simpliaelectronics/compact-hw/M.2/imxrt1052/README.md

# COMPACT 1052 Module documentation pack

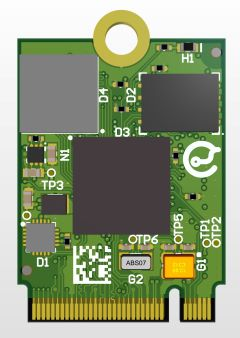
[picture p1: M.2/imxrt1052/images/compact_imxrt1052.jpg]
Compact imxrt1052


This pack includes:

* [Datasheet](/M.2/imxrt1052/DATASHEET.md)
* [Dimensional drawing](/M.2/imxrt1052/MOD_IMXRT_COMPACT_DIM.pdf)
* [3D STEP file](/M.2/imxrt1052/MOD_IMXRT_COMPACT.step)
* [Component footprint](/M.2/imxrt1052/Placement_Layout.pdf)

All documents correspond to HW revision 1.
