simpliaelectronics/compact-hw/M.2/imxrt1052/MOD_IMXRT_COMPACT.step

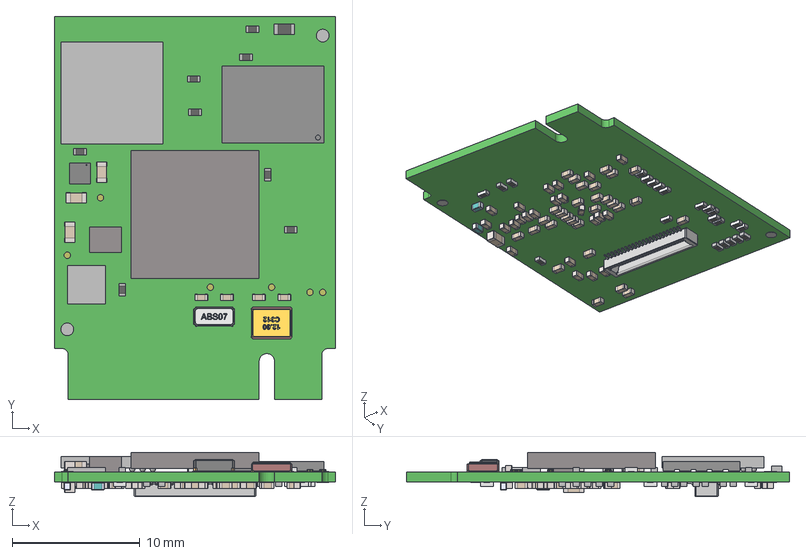
[picture p6: CAD file, 2021-03-10]
M.2/imxrt1052/MOD_IMXRT_COMPACT.step
22.0 x 30.0 x 3.46 mm
SMD_CAPACITOR_0603 x 4
Extruded x 10
SMD_RESISTOR_0402 x 30
TMLF-6_MT_MCH-L
SMD_CAPACITOR_0402 x 56
SMD_INDUCTOR_0402 x 2
DF40C-40DP
W25Q128JVEIQ
SMD_RESISTOR_0603
User_Library-ABS07_ABS07_Body_2
User_Library-ABS07_ABS07_Body2_2
User_Library-ABS07_ABS07_Beschriftung_2
User_Library-ABS07_ABS07_Pads_2
Cuartz_Crystal_3.2x2.5_SMT_4PAD
