simpliaelectronics/compact-hw/M.2/imxrt1052/MOD_IMXRT_COMPACT_DIM.pdf

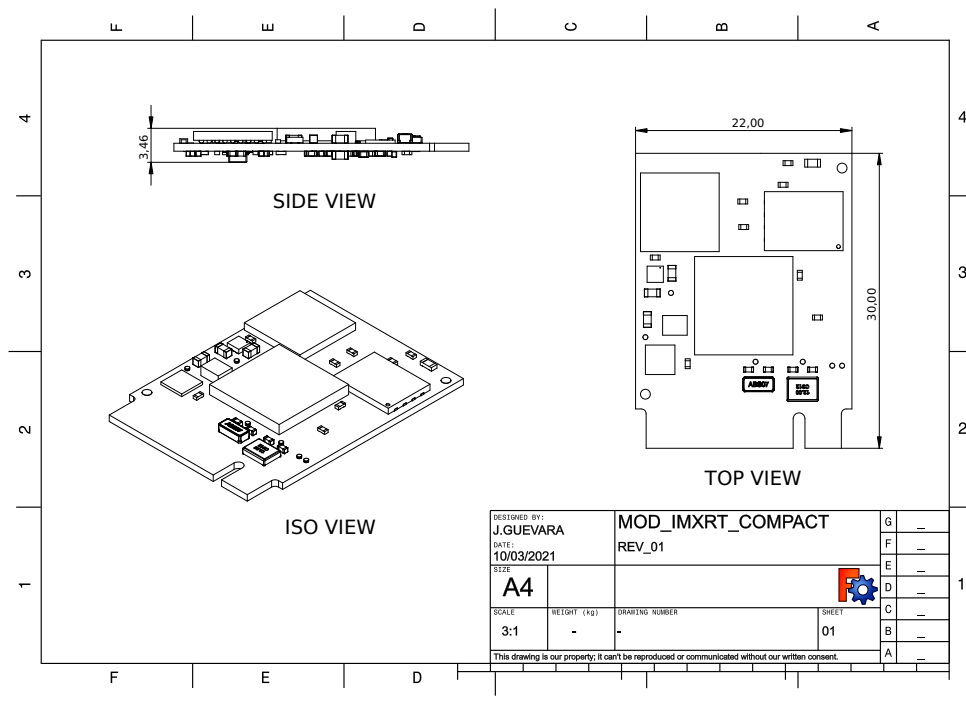
[picture p7: page 1]
SIDE VIEW; TOP VIEW; ISO VIEW
