simpliaelectronics/compact-hw/(commit log)

2021-03-10 Updated documentation
    Changed datasheet.
    Added dimmensions drawing
    Added 3D step file
    [MOD_IMXRT_COMPACT.step]
2021-03-11 Updated documentation
    Added info regarding the processor and secure element.
    Power consumption renamed to operating conditions.
    Tested connectors added.
2021-04-09 Folder structure modified to match product tree
    Folder structure modified to match product tree
    [MOD_IMXRT_COMPACT.step]
2021-04-13 Footprint added
2021-04-13 Update footprint
